r00takaspin/esp32-fob/README.md

# FOB-1 — аппаратный TOTP-брелок

Автономный генератор одноразовых паролей (TOTP) в корпусе-брелоке.
Код считается на устройстве (XIAO ESP32-C3) и показывается на OLED;
точное время держит отдельная микросхема часов PCF8563.
Телефон и сеть для работы не нужны.

**Корпус:** 46 × 24 × 17 мм (с проушиной 54,8 мм), PETG, 2 детали.
**Питание:** LiPo 3,7 В 100 мА·ч (401120, 20 × 11 × 4), зарядка по USB-C.

## Возможности

- TOTP, 6 цифр, окно 30 с
- OLED 0,91″ 128×32, SSD1306 (I2C, 0x3C)
- RTC PCF8563 (I2C, 0x51), модуль с кварцем на плате
- Одна **мембранная кнопка на 2 проводах** (D1 + GND)
- Сон, пробуждение по кнопке

## Распиновка (XIAO ESP32-C3)

| Пин XIAO | GPIO | Куда |
|---|---|---|
| 3V3 | — | OLED VCC, RTC VDD |
| GND | — | OLED GND, RTC GND, кнопка (провод 2) |
| D4 | GPIO6 | I2C **SDA** → OLED SDA, RTC SDA |
| D5 | GPIO7 | I2C **SCL** → OLED SCL, RTC SCL |
| D1 | GPIO3 | Кнопка (провод 1) |
| BAT+ | — | АКБ + |
| BAT− | — | АКБ − |

Кнопка: `INPUT_PULLUP`, активный уровень LOW.

## Комплектующие

| # | Позиция | Параметры | Кол-во |
|---|---|---|---|
| 1 | МК | XIAO ESP32-C3 (21 × 17,8 мм) | 1 |
| 2 | Дисплей | OLED 0,91″ 128×32, SSD1306, I2C | 1 |
| 3 | Часы | PCF8563 42 × 17 (кварц на плате) | 1 |
| 4 | АКБ | LiPo 3,7 В, 100 мА·ч (401120, 20 × 11 × 4), с PCM | 1 |
| 5 | Кнопка | мембранная, 2 провода (готовая) | 1 |
| 6 | Провод | МГТФ 0,2 мм², ~1 м | 1 |
| 7 | Корпус | PETG, 2 детали | 1 |
| 8 | Люверс | Ø3,6 × 2,0, латунь — можно не ставить * | 1 |
| 9 | Кольцо | разрезное, 25 мм | 1 |

Полная спецификация с ценами: [`BOM_FOB-1.csv`](BOM_FOB-1.csv).

\* Отверстие проушины сквозное, 17 мм — короткий люверс (2 мм) не подходит.
Печатного отверстия достаточно; при желании — трубчатый люверс Ø3,6 × 17.

## Печать

PETG, сопло 0,4, слой 0,2, 3 периметра, заполнение 20 %.
Стакан — **дном на стол** (полостью вверх), крышка — **лицом вниз**;
поддержки не нужны. Углы полости R1,8: если углы напечатаются с наплывом,
пройти надфилем до посадки RTC и АКБ.

## Сборка

Стакан переворачивается дном вверх и заполняется слоями:
АКБ (на поролоновой прокладке ~1,5 мм) → XIAO правым краем в прорезь стенки
(разъём USB-C оказывается заподлицо с корпусом) → RTC ложится на плату и АКБ →
дисплей в карман из 4 рёбер на крышке → крышка надевается на паз.
Мембранная кнопка клеится снаружи, её провода — в отверстие Ø2,5 слева от неё.

## Схема пайки

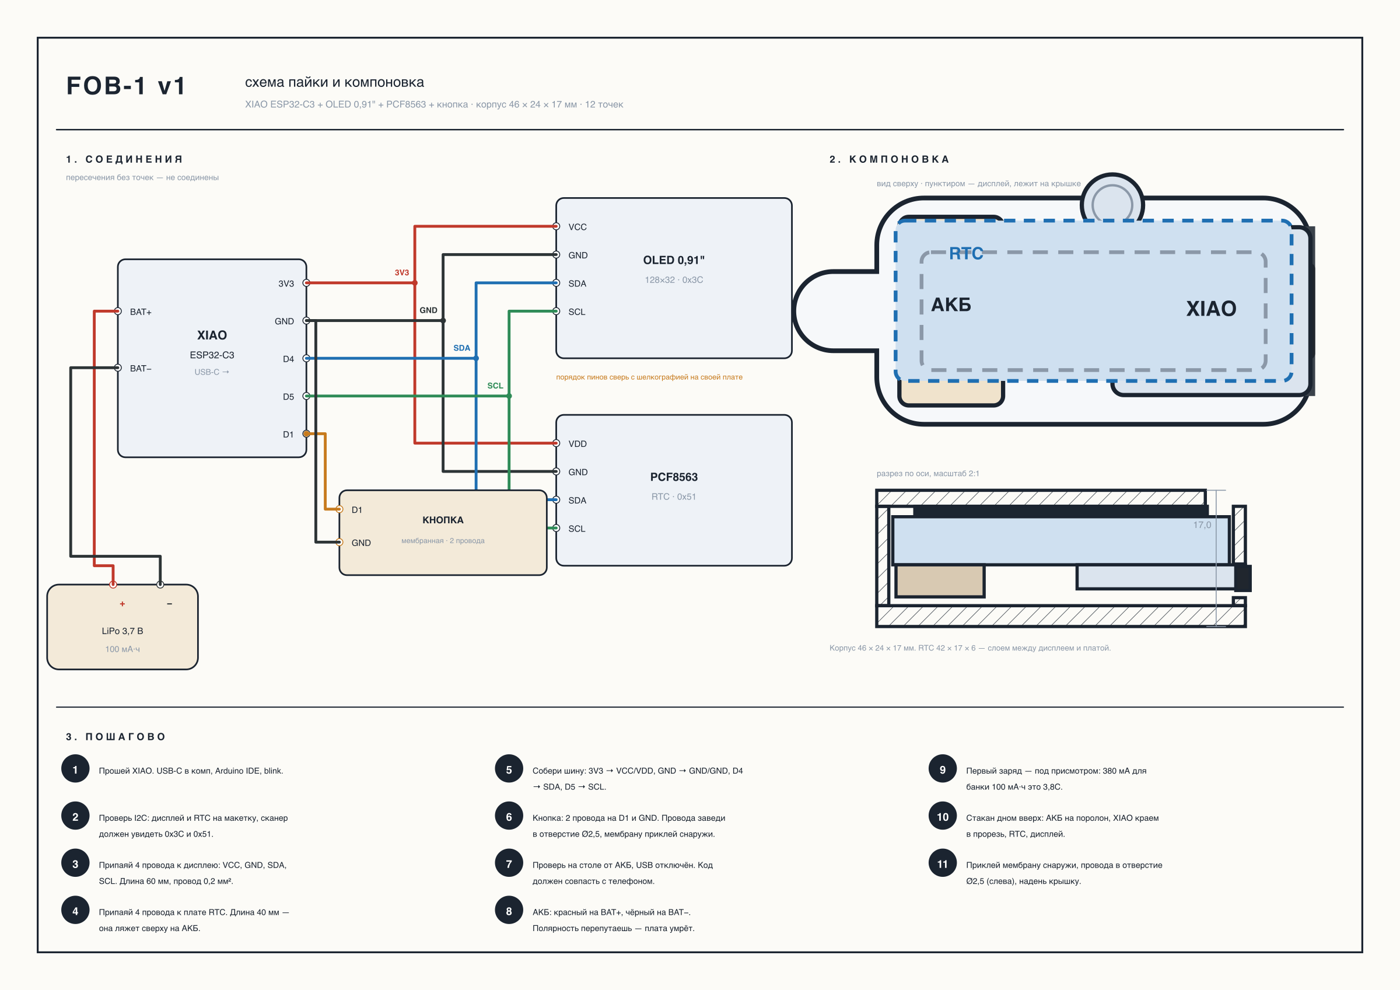
[picture p1: FOB-1_payka.png]
Схема пайки


## Сборка (разнесённый вид)

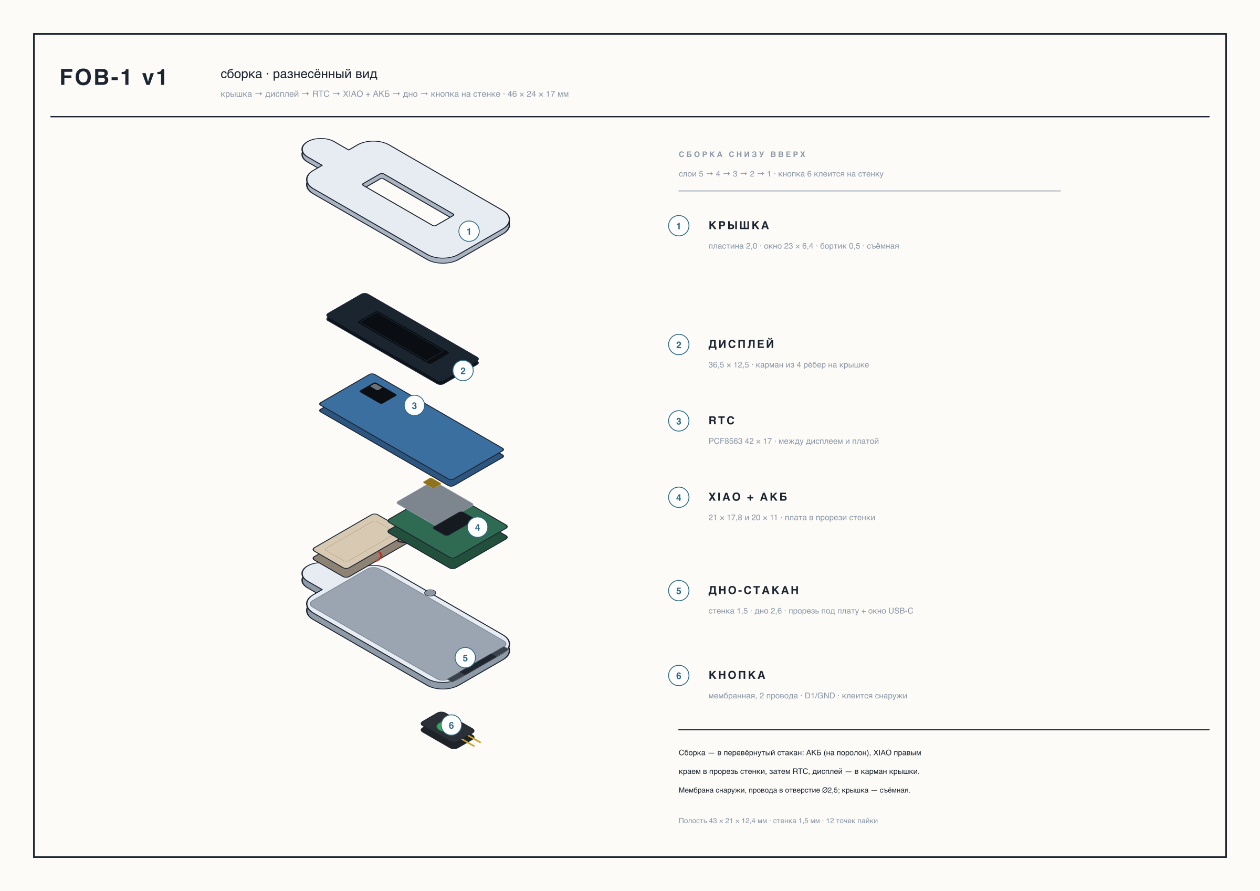
[picture p2: FOB-1_assembly_iso.png]
Сборка


## 3D-вид

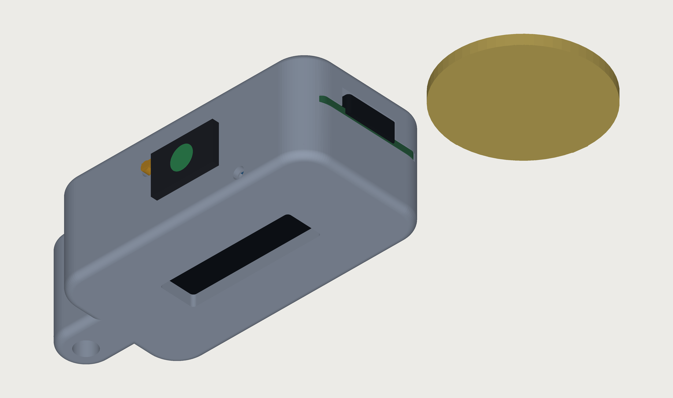
[picture p3: FOB-1_3d_side.png]
3D-вид


## Узел мембранной кнопки

Кнопка приклеивается **снаружи** на переднюю стенку, два её провода
заводятся внутрь через отверстие Ø2,5 слева от накладки (выходит в свободный
канал между АКБ и платой) и припаиваются к D1 и GND.

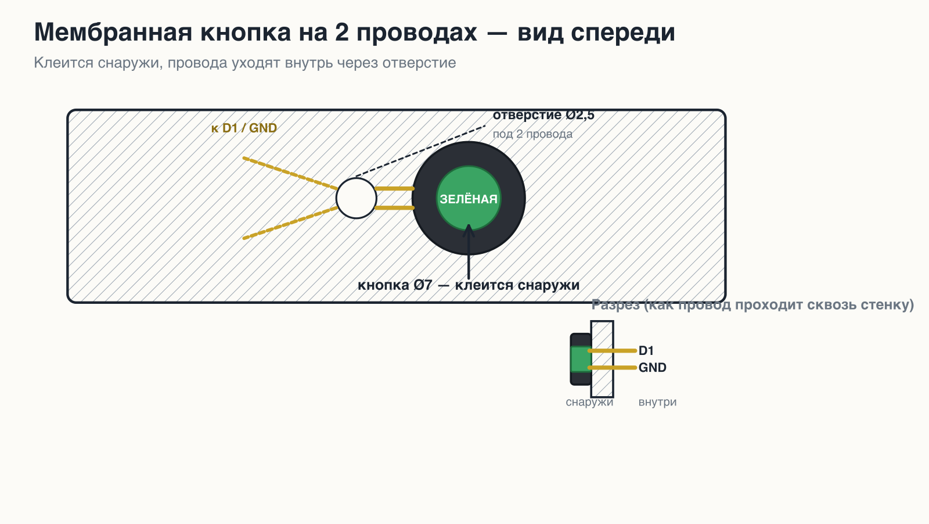
[picture p4: FOB-1_membrane_2wire.png]
Узел кнопки


## Структура репозитория

```
.
├── v1_full.py                 # 3D-модель корпуса (CadQuery) → STEP/STL
├── parts/                     # готовые модели для печати
│   ├── v1_back.step / .stl    # дно-стакан (с отверстием под провода)
│   └── v1_cover.step / .stl   # крышка с окном дисплея
├── wiring.py                  # схема пайки и компоновка
├── iso.py                     # изометрия сборки
├── membrane_2wire_diagram.py  # схема узла кнопки
├── build_doc.py               # сборка .docx
├── render_final.py            # 3D-рендер
├── FOB-1_payka.png / .svg     # схема пайки и компоновка
├── FOB-1_assembly_iso.png/.svg # изометрия сборки
├── FOB-1_3d_side.png          # 3D-вид
├── FOB-1_membrane_2wire.png   # узел мембранной кнопки
├── BOM_FOB-1.csv              # спецификация
├── FOB-1_dokumentaciya.docx   # техническая документация
└── build.sh                   # пересборка всех артефактов
```

## Пересборка

```bash
python3 -m venv .venv && source .venv/bin/activate
pip install -r requirements.txt

./build.sh                 # или: PY=.venv/bin/python ./build.sh
```

`build.sh` требует `rsvg-convert` (librsvg) для SVG → PNG.

## Лицензия

MIT — см. [`LICENSE`](LICENSE).
