r00takaspin/esp32-fob/FOB-1_dokumentaciya.docx

FOB-1

Аппаратный TOTP-брелок

Техническая документация · версия v1

Аппаратная часть, сборка, прошивка, переход на серийную плату

Ревизия 1.1 · корпус проверен на пересечения с начинкой

# 1. Назначение и параметры

FOB-1 — автономный генератор одноразовых паролей (TOTP) в корпусе-брелоке. Код считается на устройстве из секрета, хранящегося в памяти, и показывается на встроенном экране. Телефон и сеть для работы не нужны: радио в устройстве не используется.

Ключевая идея: точное время держит отдельная микросхема часов (PCF8563), поэтому брелок не зависит от синхронизации в момент показа кода. Радио включается только при зарядке, если пользователь захочет синхронизировать время по Wi-Fi.

Параметр | Значение
Габарит | 46 × 24 × 17 мм (с проушиной 54,8 мм)
Масса | ≈ 25 г
Питание | LiPo 3,7 В, 100 мА·ч (401120, 20 × 11 × 4)
Автономность | ~30 дней при 20 нажатиях в день
Дисплей | OLED 0,91", 128×32, I2C
Часы | PCF8563 + кварц 32,768 кГц, ±20 ppm
Интерфейс | одна кнопка, код 6 цифр, окно 30 с
Зарядка | USB-C, 380 мА (штатный зарядник XIAO)

# 2. Схема соединений

Всё висит на одной шине I2C. Адреса не конфликтуют: дисплей 0x3C, часы 0x51. Питание 3,3 В берётся с выхода XIAO, он же питает дисплей и RTC.

Сигнал | XIAO | Дисплей | RTC
Питание +3,3 В | 3V3 | VCC | VDD
Земля | GND | GND | GND
Данные I2C | D4 (GPIO6) | SDA | SDA
Такт I2C | D5 (GPIO7) | SCL | SCL
Кнопка | D1 (GPIO3) | — | —
АКБ | BAT+ / BAT− | — | —

Итого 12 точек пайки: 4 на дисплей, 4 на RTC, 2 на аккумулятор, 2 на кнопку. Кнопка — мембранная на 2 проводах (D1 + GND), провода через отверстие в стенке.


Лист 1. Схема пайки, компоновка, разрез и порядок сборки.

# 3. Комплектующие

№ | Позиция | Наименование | Кол-во | Цена, $
1 | МК | XIAO ESP32-C3 (21 × 17,8 мм) | 1 | 5,00
2 | Дисплей | OLED 0,91" 128×32, SSD1306, I2C | 1 | 1,80
3 | Часы | PCF8563 42 × 17 (кварц на плате) | 1 | 1,50
4 | АКБ | LiPo 3,7 В, 100 мА·ч (401120, 20 × 11 × 4), с PCM | 1 | 2,60
5 | Кнопка | Мембранная готовая, 2 провода (как на фото) | 1 | 0,50
6 | Провод | МГТФ 0,2 мм², ~1 м | 1 | 0,30
7 | Корпус | PETG, 2 детали: крышка, стакан | 1 | 1,50
8 | Люверс | Ø3,6 × 2,0, латунь — не ставится * | 1 | 0,10
9 | Кольцо | разрезное, 25 мм | 1 | 0,10
| | Итого | | ≈ 13,40

* Люверс Ø3,6 × 2,0 не подходит: отверстие проушины сквозное, 17 мм. Печатного отверстия достаточно; при желании — трубчатый люверс Ø3,6 × 17.

# 4. Сборка

Порядок важен: сначала проверка на столе, только потом укладка в корпус. Если собрать сразу в корпус, отладка превращается в разборку.

- Прошить XIAO, проверить, что плата видится в Arduino IDE.
- Собрать I2C на макетке, прогнать сканер: должны появиться 0x3C и 0x51.
- Припаять 4 провода к дисплею и 4 к плате RTC, длиной 60 и 40 мм.
- Соединить шину по таблице раздела 2.
- Припаять кнопку: 2 провода на D1 и GND, мембрану приклеить снаружи.
- Проверить на столе от аккумулятора: код должен совпадать с телефоном.
- Припаять аккумулятор, соблюдая полярность (красный — BAT+).
- Первый заряд провести под присмотром: ток 380 мА для банки 100 мА·ч это 3,8C.
- Стакан перевернуть дном вверх: АКБ на поролоновую прокладку, XIAO — правым краем в прорезь стенки, затем RTC (ляжет на плату и АКБ).
- Провода дисплея и RTC — вдоль задней стенки, провода кнопки — в канал между АКБ и платой.
- Приклеить мембранную кнопку снаружи, провода завести в отверстие Ø2,5 слева от неё.
- Дисплей — в карман из 4 рёбер на крышке, крышку надеть на стакан (бортик в паз).


Лист 2. Изометрия сборки: пять слоёв, порядок снизу вверх.

# 5. Корпус

Корпус состоит из двух деталей: крышка-пластина и дно-стакан. Вся жёсткость в стакане, крышка закрывает полость и несёт окно дисплея.

Элемент | Размер
Габарит | 46 × 24 × 17 мм (54,8 мм с проушиной)
Стенка | 1,5 мм
Дно | 2,6 мм
Полость | 43 × 21 × 12,4 мм, углы R1,8
Окно дисплея | 23 × 6,4 мм
Прорезь под плату | 18 × 1,3 мм в правом торце, край XIAO заподлицо снаружи
Окно USB-C | 10,2 × 4,2 мм в правом торце
Кнопка (мембрана) | накладка снаружи + отверстие Ø2,5 слева от неё
Фиксация дисплея | 4 ребра 0,6 × 1,3 мм на крышке
Крышка | съёмная: бортик 0,5 × 0,8 в паз 0,8 (зазор 0,15) + паз под ноготь
Кромки | скруглены R1,2 сверху и снизу
Фиксация платы | край платы в прорези стенки, левый край лежит на RTC
Фиксация АКБ | поролоновая прокладка ~1,5 мм под АКБ
Место под RTC | 42 × 17 × 6 мм, слой между дисплеем и платой
Проушина | Ø3,6 мм сквозное (17 мм), люверс не нужен

Печать: PETG, сопло 0,4, слой 0,2, три периметра, заполнение 20 %. Дно печатать дном на стол, крышку — лицевой стороной вниз: поддержки не нужны. Если углы полости напечатались с наплывом — пройти надфилем до посадки RTC и АКБ.

Файлы модели: parts/v1_back.step / .stl, parts/v1_cover.step / .stl. Крышка съёмная: бортик входит в паз с зазором 0,15 мм на сторону, паз под ноготь на переднем торце. Клей не нужен.

# 6. Прошивка

## 6.1. Пины

I2C — D4/D5 (GPIO6/GPIO7), выделенные пины XIAO, не стреппинговые. Кнопка — D1 (GPIO3): мембранная на 2 проводах, INPUT_PULLUP, активный LOW.

## 6.2. Цикл работы

сон → прерывание по кнопке → чтение RTC (I2C) → HMAC-SHA1(секрет, t/30)
→ отрисовка 6 цифр + таймер → 20 с бездействия → сон

Дисплей включается только на время показа. При 20 нажатиях по 15 секунд это около 2,1 мА·ч в сутки — вдвое больше, чем сон. Поэтому основная экономия не в сне, а в том, чтобы не держать экран включённым.

## 6.3. Калибровка часов

Кварц даёт ±20 ppm — это 1,7 секунды в сутки. Без коррекции код начинает расходиться с сервером примерно через 17 дней, а окно TOTP — 30 секунд.

При каждой синхронизации считается накопленный уход и сохраняется поправка:

уход_ppm = (t_хоста − t_RTC) / t_RTC × 1e6
t_испр = t_RTC + (t_RTC − t_синка) × ppm / 1e6

Поправка хранится в NVS. После двух-трёх синхронизаций сходится к ±5 ppm — это 13 секунд за 30 дней, в пределах допуска на весь межзарядный цикл.

Синхронизация: по USB с компьютера (просто, но нужен ноутбук) или по Wi-Fi через SNTP при зарядке (без компьютера, стоит ~0,1 мА·ч на сеанс).

# 7. Проверка и приёмка

Проверка | Норма | Как
Плата видится | да | Arduino IDE, порт
I2C-устройства | 0x3C и 0x51 | сканер I2C
Код совпадает | да | сравнить с телефоном 2–3 раза подряд
Ток в сне | < 1 мА | мультиметр в разрыв АКБ после пробуждения и сна
Кнопка | пробуждает и показывает | нажать, подождать 20 с, нажать снова
Дисплей | без перекоса и засветки | визуально через окно
USB-C | штекер входит до упора | проверить до надевания крышки
Заряд | набор тока, нагрев умеренный | контроль первые 10 минут

# 8. Состав пакета

Файл | Что это
FOB-1_payka.png / .svg | лист схемы пайки и компоновки
FOB-1_assembly_iso.png / .svg | изометрия сборки
FOB-1_3d_side.png | 3D-вид с монетой для масштаба
FOB-1_membrane_2wire.png | узел мембранной кнопки
v1_cover.step / .stl | крышка для печати
v1_back.step / .stl | дно-стакан для печати
BOM_FOB-1.csv | спецификация с ценами

Файлы STEP — твердотельные модели в миллиметрах, открываются в любом CAD. STL — для слайсера.
