r00takaspin/esp32-fob/BOM_FOB-1.csv

N | Позиция | Наименование / параметры | Кол-во | Цена, $ | Сумма, $ | Где брать | Примечание
1 | МК | XIAO ESP32-C3 (21 × 17,8 мм) | 1 | 5.00 | 5.00 | AliExpress / Seeed | штатный зарядник 380 мА
2 | Дисплей | OLED 0,91" 128×32, SSD1306, I2C | 1 | 1.80 | 1.80 | AliExpress | адрес 0x3C
3 | Часы | PCF8563 42×17 (кварц уже на плате) | 1 | 1.50 | 1.50 | AliExpress | адрес 0x51
4 | АКБ | LiPo 3,7 В, 100 мА·ч (401120, 20×11×4), с PCM | 1 | 2.60 | 2.60 | AliExpress | строго с защитой
5 | Кнопка | Мембранная готовая, 2 провода (как на фото) | 1 | 0.50 | 0.50 | AliExpress | клеится снаружи
6 | Провод | МГТФ 0,2 мм², ~1 м | 1 | 0.30 | 0.30 | Чип и Дип
7 | Корпус | PETG, 2 детали: крышка, стакан | 1 | 1.50 | 1.50 | свой принтер
8 | Люверс | Ø3,6 × 2,0, латунь | 1 | 0.10 | 0.10 | AliExpress | НЕ ставится: отверстие сквозное 17 мм | при желании — трубчатый Ø3,6×17
9 | Кольцо | разрезное, 25 мм | 1 | 0.10 | 0.10 | AliExpress
 |  |  |  | ИТОГО | 13.40 |  | без доставки
