r00takaspin/esp32-fob/parts/v1_cover.step

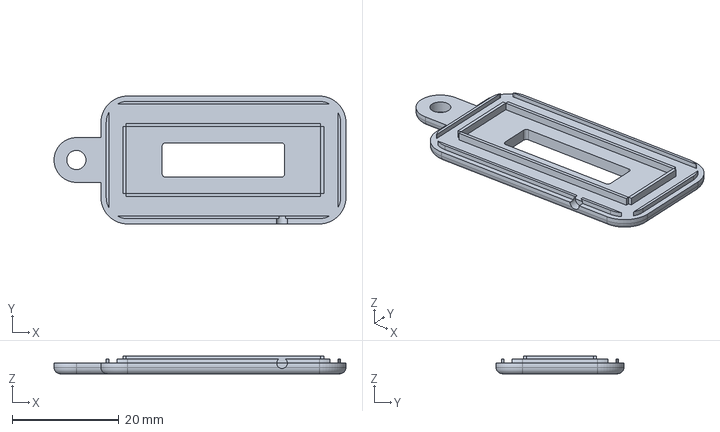
[picture p5: CAD file, 2026-10-27]
parts/v1_cover.step
54.8 x 24.0 x 3.30 mm
