r00takaspin/esp32-fob/parts/v1_back.step

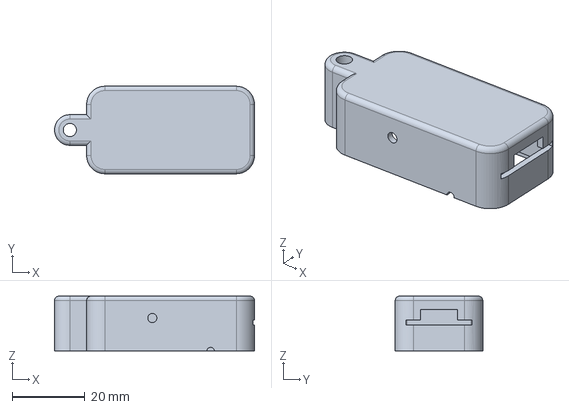
[picture p6: CAD file, 2026-10-27]
parts/v1_back.step
54.8 x 24.0 x 15.0 mm
