r00takaspin/esp32-fob/(list of files, cad)

Other CAD files:
parts/v1_back.stl
parts/v1_cover.stl
