r00takaspin/esp32-fob/(commit log)

2026-10-26 FOB-1: аппаратный TOTP-брелок — модель, схемы, документация
    [BOM_FOB-1.csv, v1_back.step, v1_back.stl, v1_cover.step, v1_cover.stl]
2026-10-26 docs: убрать тактовую кнопку из спецификации (только мембранная на 2 проводах)
2026-10-26 Корпус 41×22×14: отдельное место под макетку RTC 15×10×4,5
    [BOM_FOB-1.csv, v1_back.step, v1_back.stl, v1_cover.step]
2026-10-26 Корпус 41×24×17 под готовый модуль RTC HW-689 30×20×7
    [BOM_FOB-1.csv, v1_back.step, v1_back.stl, v1_cover.step, v1_cover.stl]
2026-10-26 АКБ под LiPo 401120 (20×11×4, 100 мА·ч): модель, BOM, схемы
    [BOM_FOB-1.csv, v1_back.step, v1_cover.step]
2026-10-26 Съёмная крышка: бортик 0,5 в паз + паз под ноготь, без клея
    [v1_back.step, v1_back.stl, v1_cover.step, v1_cover.stl]
2026-10-26 Скруглить верхнюю и нижнюю кромки корпуса R1,2
    [v1_back.step, v1_back.stl, v1_cover.step, v1_cover.stl]
2026-10-26 Корпус 46×24×17 под PCF8563 42×17×6
    [BOM_FOB-1.csv, v1_back.step, v1_back.stl, v1_cover.step, v1_cover.stl]
2026-10-26 Чистка: убрать v2/эскиз/тонкий RTC, актуализировать README, BOM и документацию
    [BOM_FOB-1.csv]
2026-10-27 изменения в конечной схеме
    [BOM_FOB-1.csv, v1_back.step, v1_back.stl, v1_cover.step, v1_cover.stl]
